shiakah27/saqai/docs/presentation/a/band.jpg

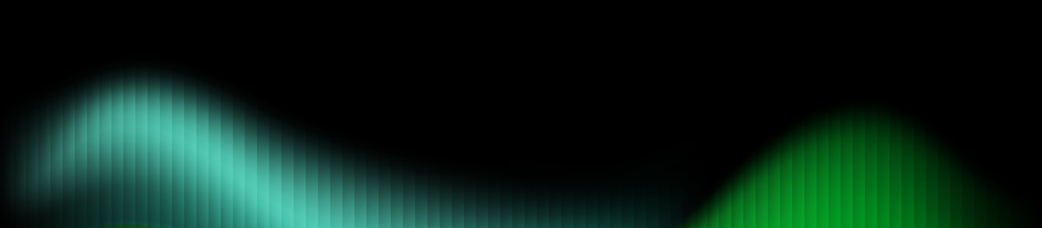
docs/presentation/a/band.jpg
