shiakah27/saqai/docs/presentation/a/c_sensor.webp

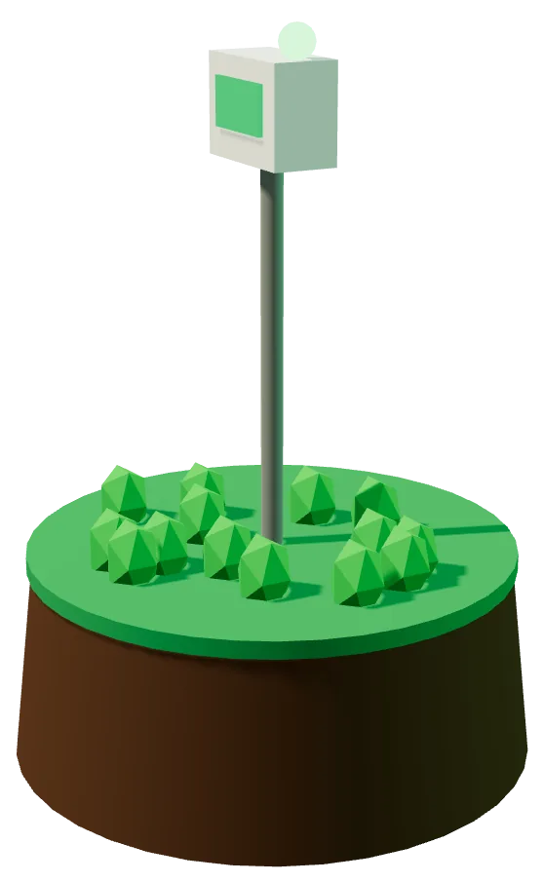
docs/presentation/a/c_sensor.webp
