shiakah27/saqai/docs/presentation/a/c_sprinkler.webp

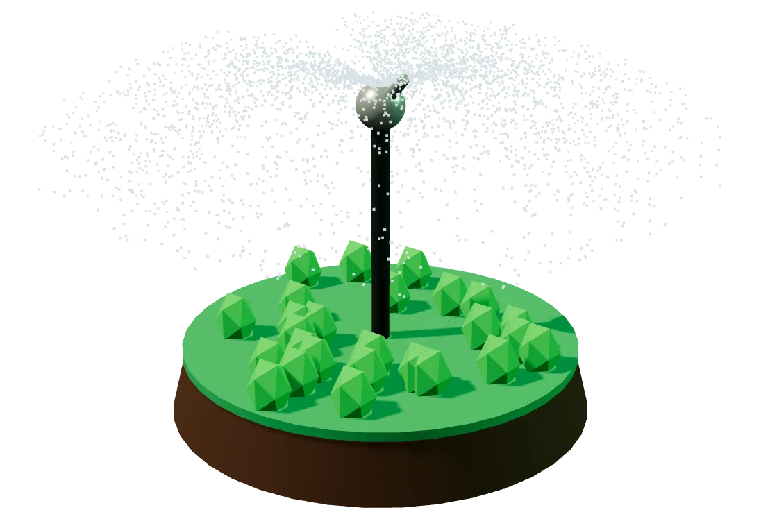
docs/presentation/a/c_sprinkler.webp
