shiakah27/saqai/docs/presentation/a/c_valve.webp

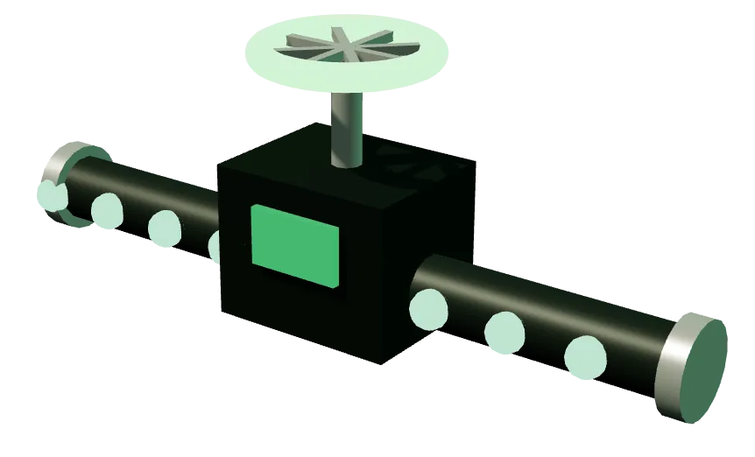
docs/presentation/a/c_valve.webp
