shiakah27/saqai/docs/presentation/a/c_weather.webp

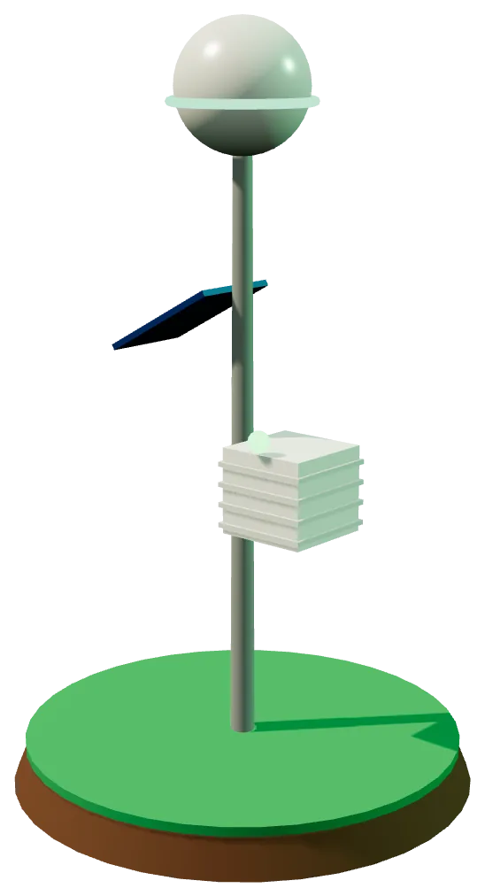
docs/presentation/a/c_weather.webp
