shiakah27/saqai/docs/presentation/a/dio_dry.webp

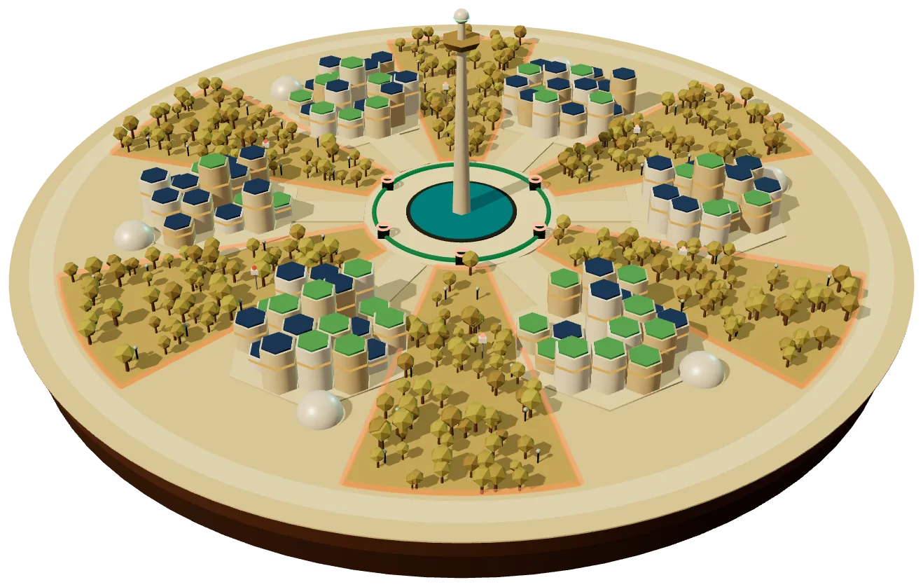
docs/presentation/a/dio_dry.webp
