shiakah27/saqai/docs/presentation/a/dio_green.webp

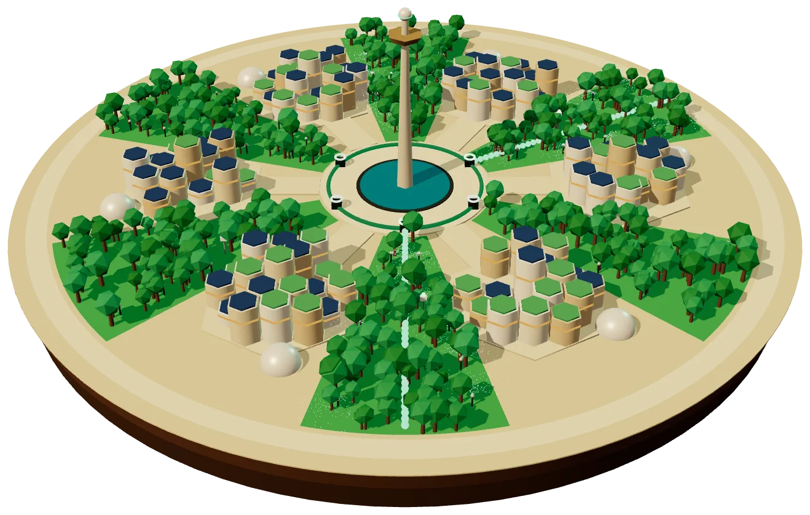
docs/presentation/a/dio_green.webp
