shiakah27/saqai/docs/presentation/a/orbit.jpg

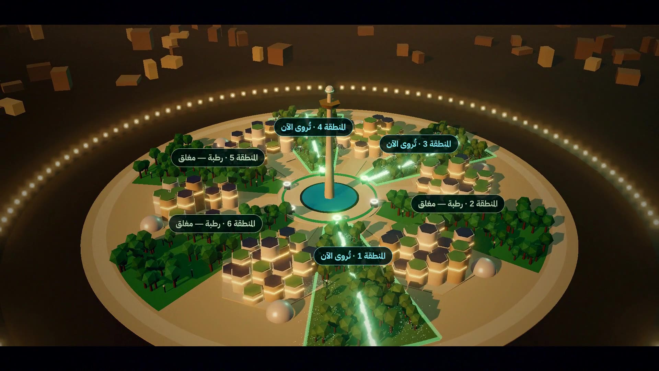
docs/presentation/a/orbit.jpg
