shiakah27/saqai/docs/presentation/a/shot_decision.jpg

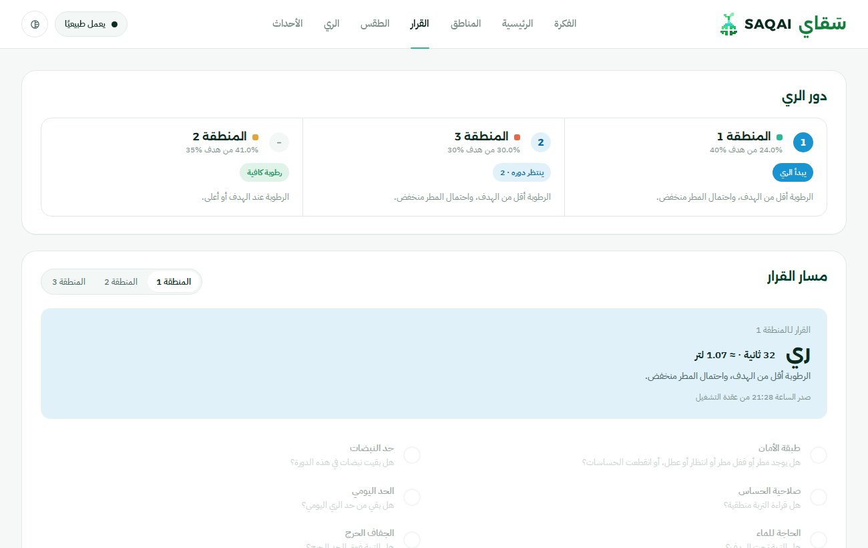
docs/presentation/a/shot_decision.jpg
