shiakah27/saqai/docs/presentation/a/shot_home.jpg

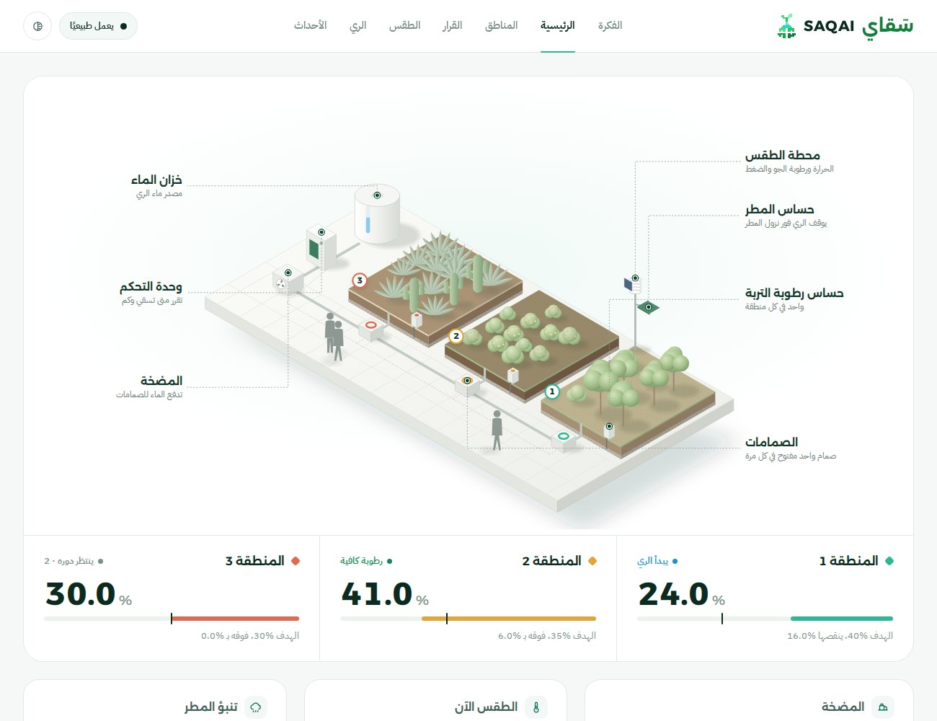
docs/presentation/a/shot_home.jpg
