shiakah27/saqai/docs/presentation/a/shot_weather.jpg

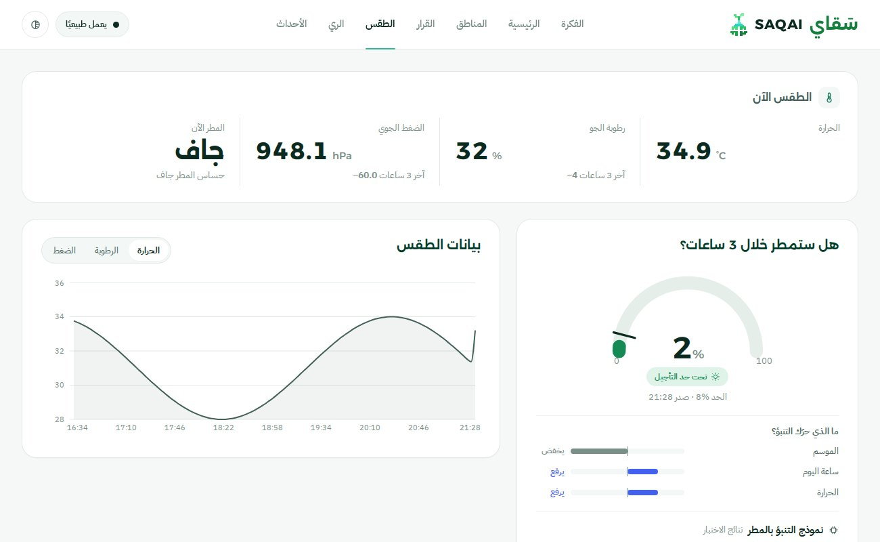
docs/presentation/a/shot_weather.jpg
