shiakah27/saqai/docs/presentation/a/tour.jpg

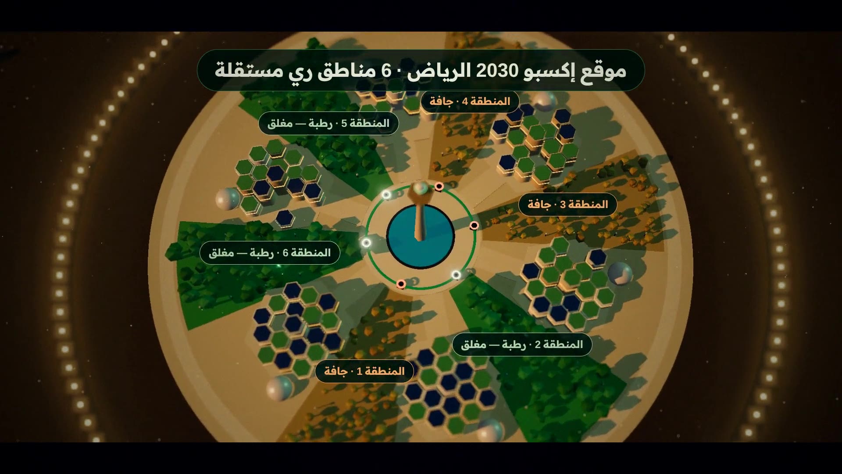
docs/presentation/a/tour.jpg
