shiakah27/saqai/(commit log)

2026-10-15 SAQAI smart irrigation system
    [riyadh_hourly_2015_2026.csv]
2026-10-15 Update GPIO pins for MH-RD rain plate module
2026-10-19 Update prototype section in README
    Removed the image placeholder and added a description of the real system built.
